JohnWSatterfield/Signal-Generator/Pictures/Front View - Si5351 Sig Gen.JPG

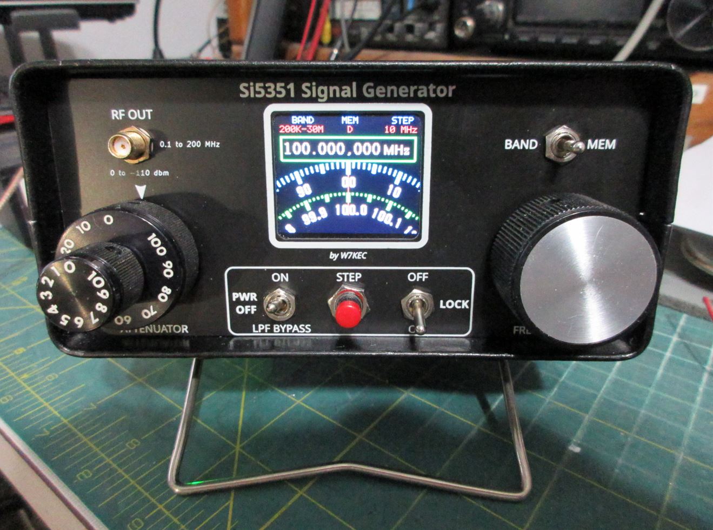
Pictures/Front View - Si5351 Sig Gen.JPG
