JohnWSatterfield/Signal-Generator/Pictures/JLCPCB Board versus Perfboard.jpg

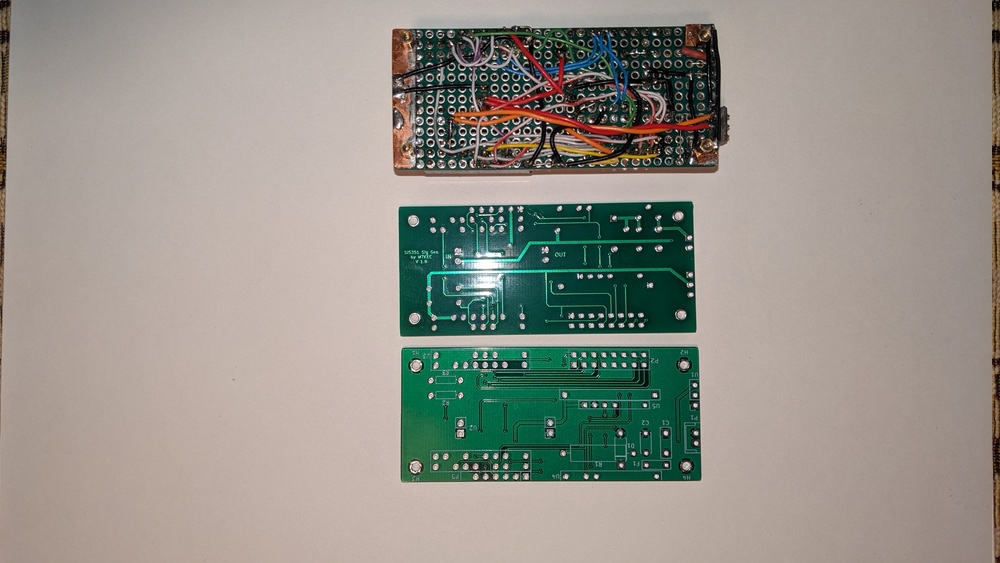
Pictures/JLCPCB Board versus Perfboard.jpg
