JohnWSatterfield/Signal-Generator/README.md

Signal Generator Project by Clint Chron and John Satterfield
This is a signal generator using a si5351 module

This is a work in process and will see periodic updates

Updated files include Documentation External Si5351 VFO V1_3.pdf
Updated files include SCR ST7735_128_160.hpp, ST7789_170x320.hpp  Changes for deprecated commands
