JohnWSatterfield/Signal-Generator/Si5351 Signal Generator - 12 Volt Power.pdf

## TFT LCD SPI ST7735

02-22-2023

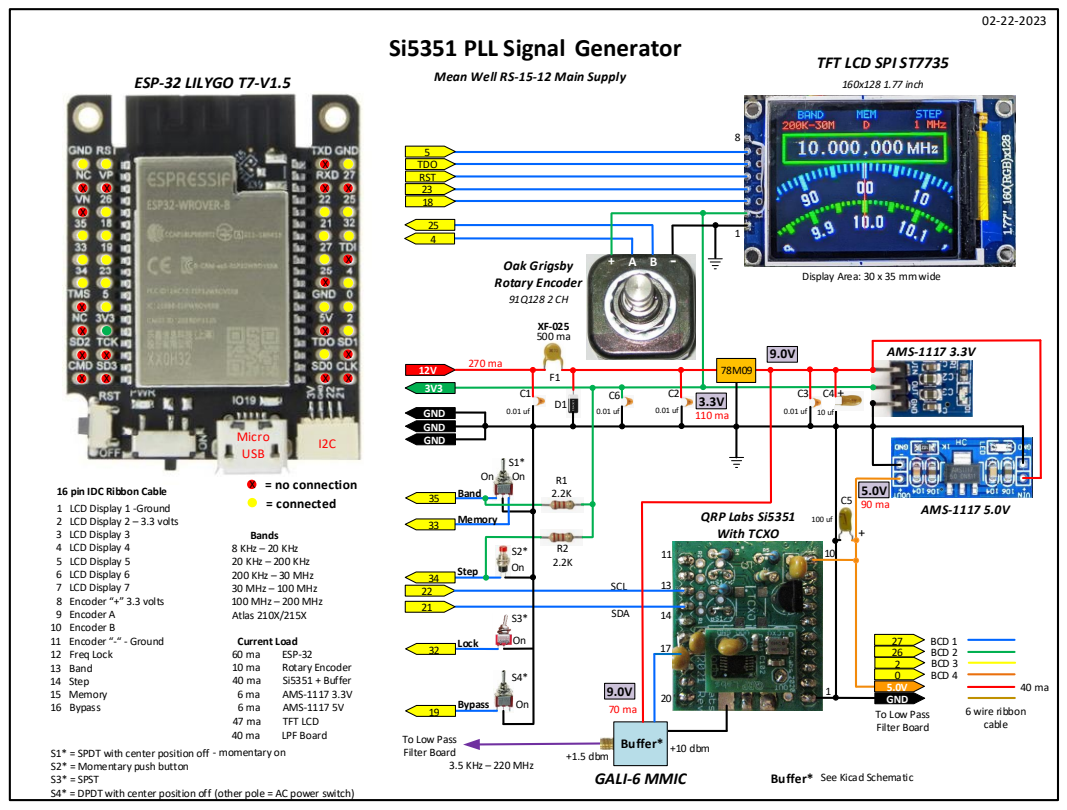
[picture p3: page 1]

Mean Well RS-15-12 Main Supply

Display Area: 30 x 35 mm wide

S1* = SPDT with center position off
S2* = Momentary push button
S3* = SPST
S4* = DPDT with center position off

Buffer* See Kicad Schematic

(other pole = AC power switch)

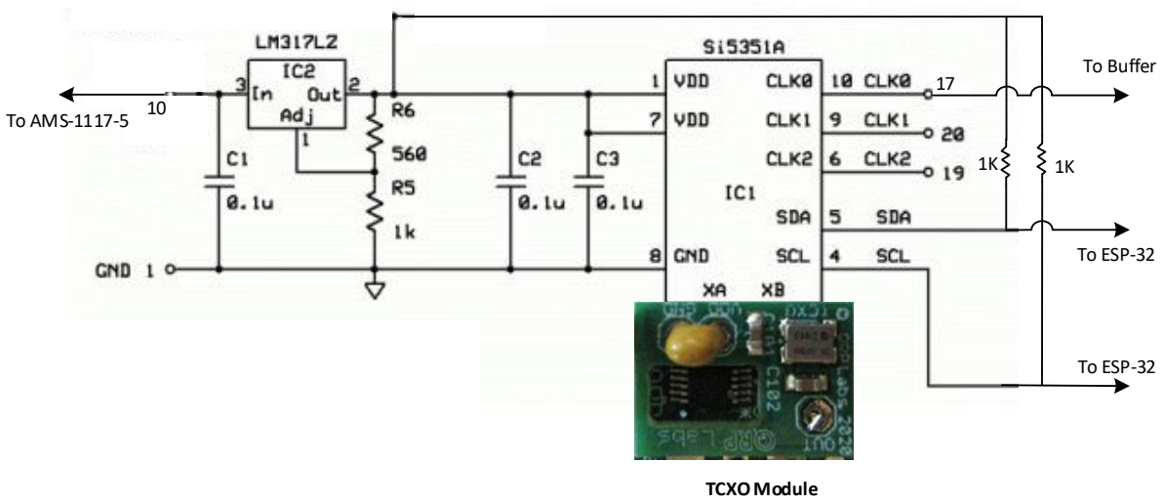
[picture p4: figure]
To ESP-32; To Buffer; TCXO Module; 10 To AMS-1117-5
