JohnWSatterfield/Signal-Generator/Pictures/finished box.jpg

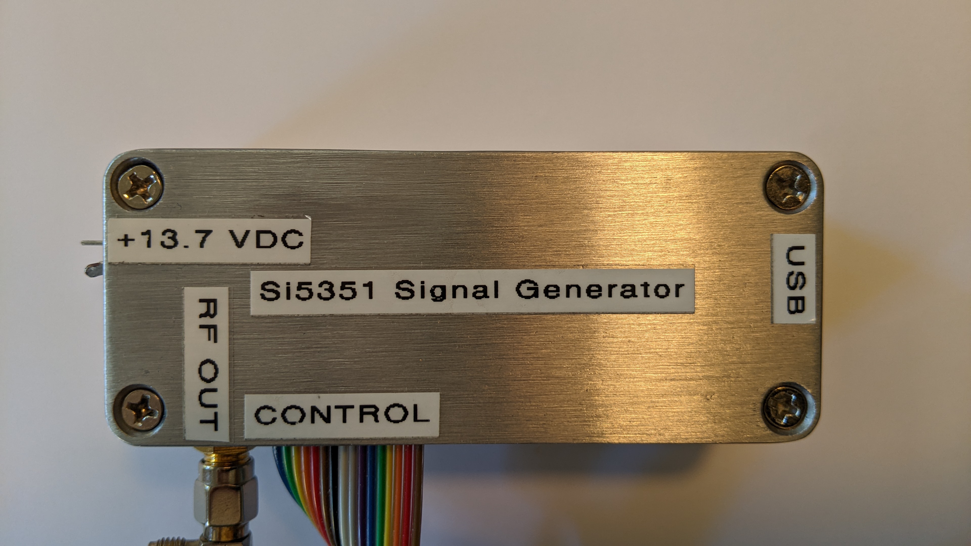
Pictures/finished box.jpg
