JohnWSatterfield/Signal-Generator/Pictures/JCLPCB Board inside box.jpg

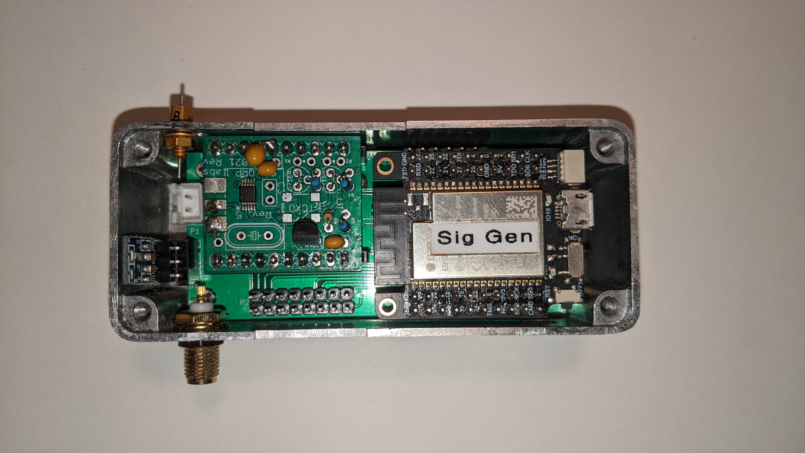
Pictures/JCLPCB Board inside box.jpg
