JohnWSatterfield/Signal-Generator/SCR/encodersetup.h

/*
 * code by JSatterfield - KI5IDZ
*/

#include "config.h"           // Hardware configuration (pin assignments & display type)


volatile long  quad = 0;
volatile long previous_data;
volatile uint8_t f_echange;
volatile bool locked = HIGH; 
void IRAM_ATTR enc_read();
//void ICACHE_RAM_ATTR enc_read();

void setupencoder() {
  pinMode(DT,  INPUT_PULLUP);
  pinMode(CLK, INPUT_PULLUP);
  
 
  // enable interrupts for rotary encoder pins
  attachInterrupt(DT,  enc_read, CHANGE);
  attachInterrupt(CLK, enc_read, CHANGE);
  previous_data = digitalRead(DT) << 1 | digitalRead(CLK);
  
}


void  enc_read()
{
 if (locked) {
  long current_data = digitalRead(DT) << 1 | digitalRead(CLK);
  if( current_data == previous_data ) {f_echange=0;return;}
  if( bitRead(current_data, 0) == bitRead(previous_data, 1) )
    quad -= 1;
  else
    quad += 1;
  previous_data = current_data;
 }
}
